ValeAleH/Proyecto_Caja_Fuerte/inc/diagrama de conexion.png

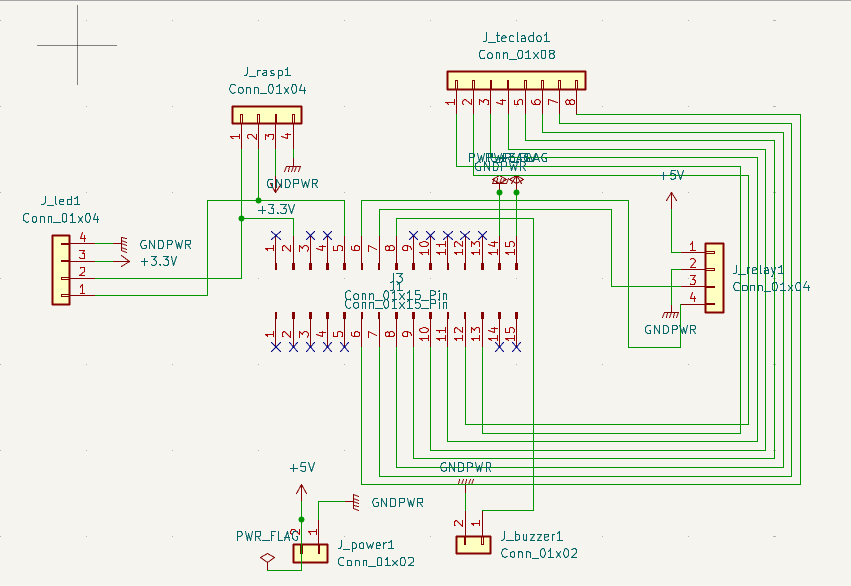
inc/diagrama de conexion.png
