ValeAleH/Proyecto_Caja_Fuerte/inc/diagrama de rutas.png

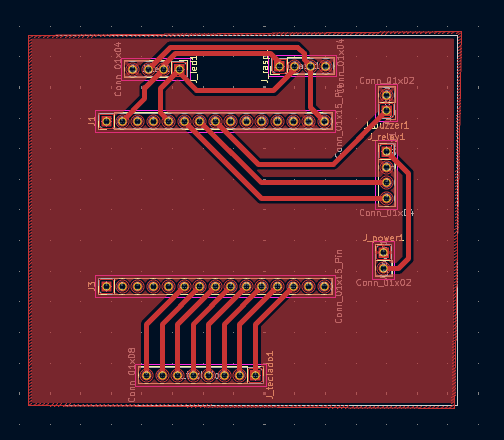
inc/diagrama de rutas.png
